mck1117/denso-wideband/nissan-wbo/export/nissan-wbo.pdf

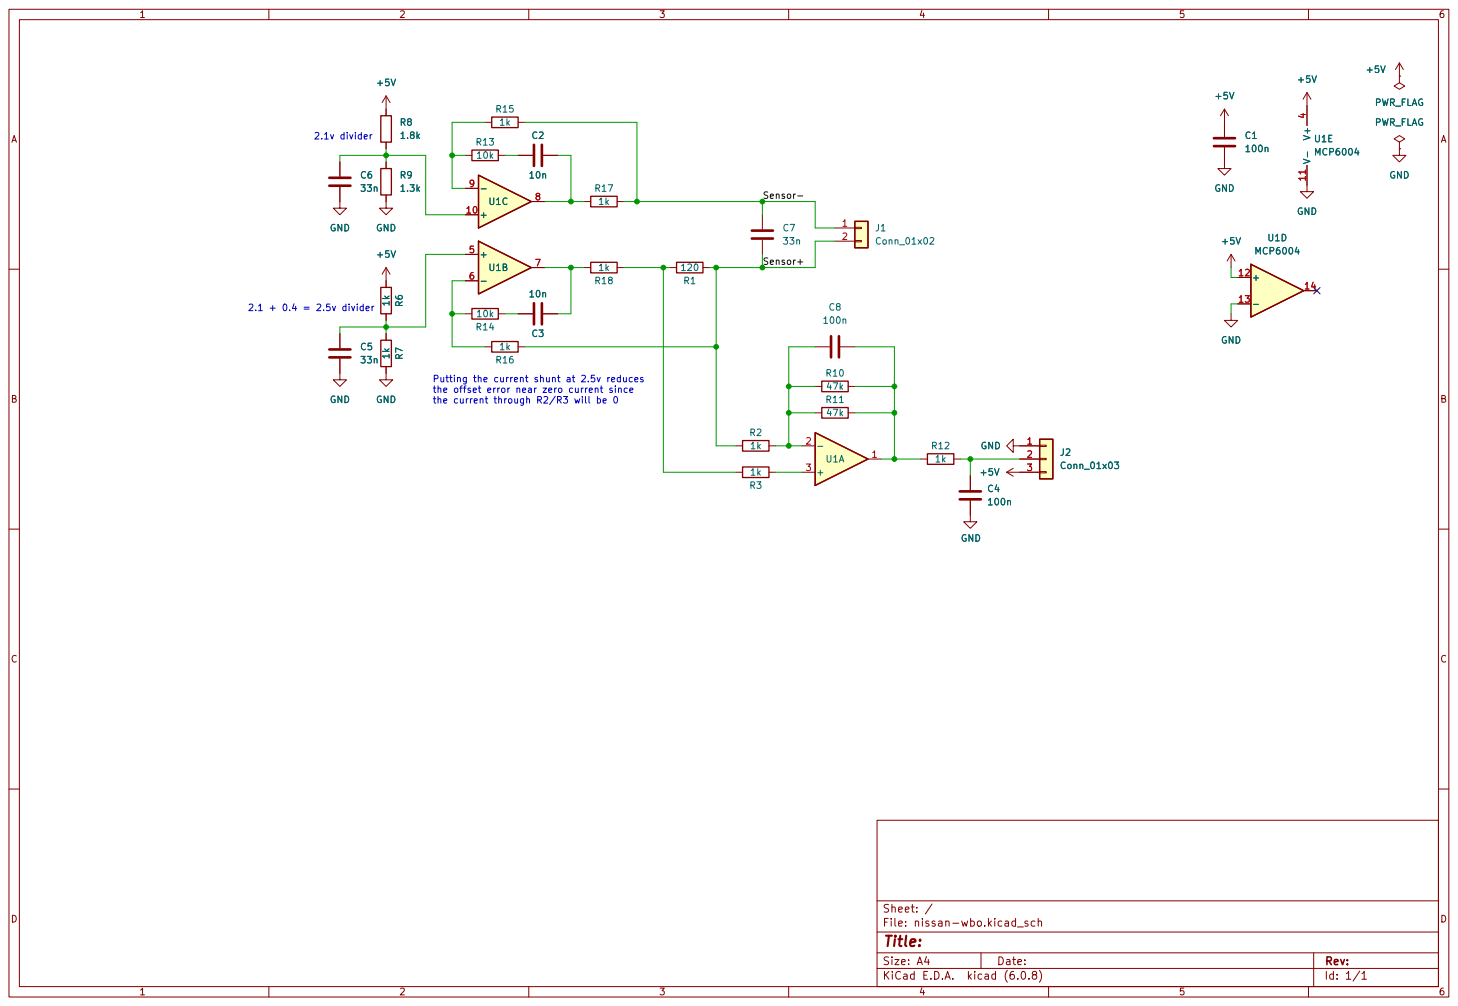
[picture p1: page 1]

the current through R2/R3 will be 0 GND

the offset error near zero current since

File: nissan-wbo.kicad_sch Sheet: /
Id: 1/1 Title:
