mck1117/denso-wideband/sim/NissanWbo.asc

C1: cap; 10n
C2: cap; 10n
C3: cap; 100n
C4: cap; 33n
I1: current; 400µ; AC 1
R1: res; 10k
R2: res; 1k
R3: res; 10k
R4: res; 1k
R5: res; 1k
R6: res; 1k
R7: res; 120
R8: res; 23.5k
R9: res; 1k
R10: res; 1k
U1: AD822
U2: AD822
U3: AD822
V1: voltage; 2.1
V2: voltage; 5
V3: voltage; 2.5
Named nets: 0, vcc, output
.dc I1 -800u 800u
