mck1117/denso-wideband/nissan-wbo/nissan-wbo.kicad_pcb

## KiCad design nissan-wbo/nissan-wbo.kicad_pcb (2023-02-02)

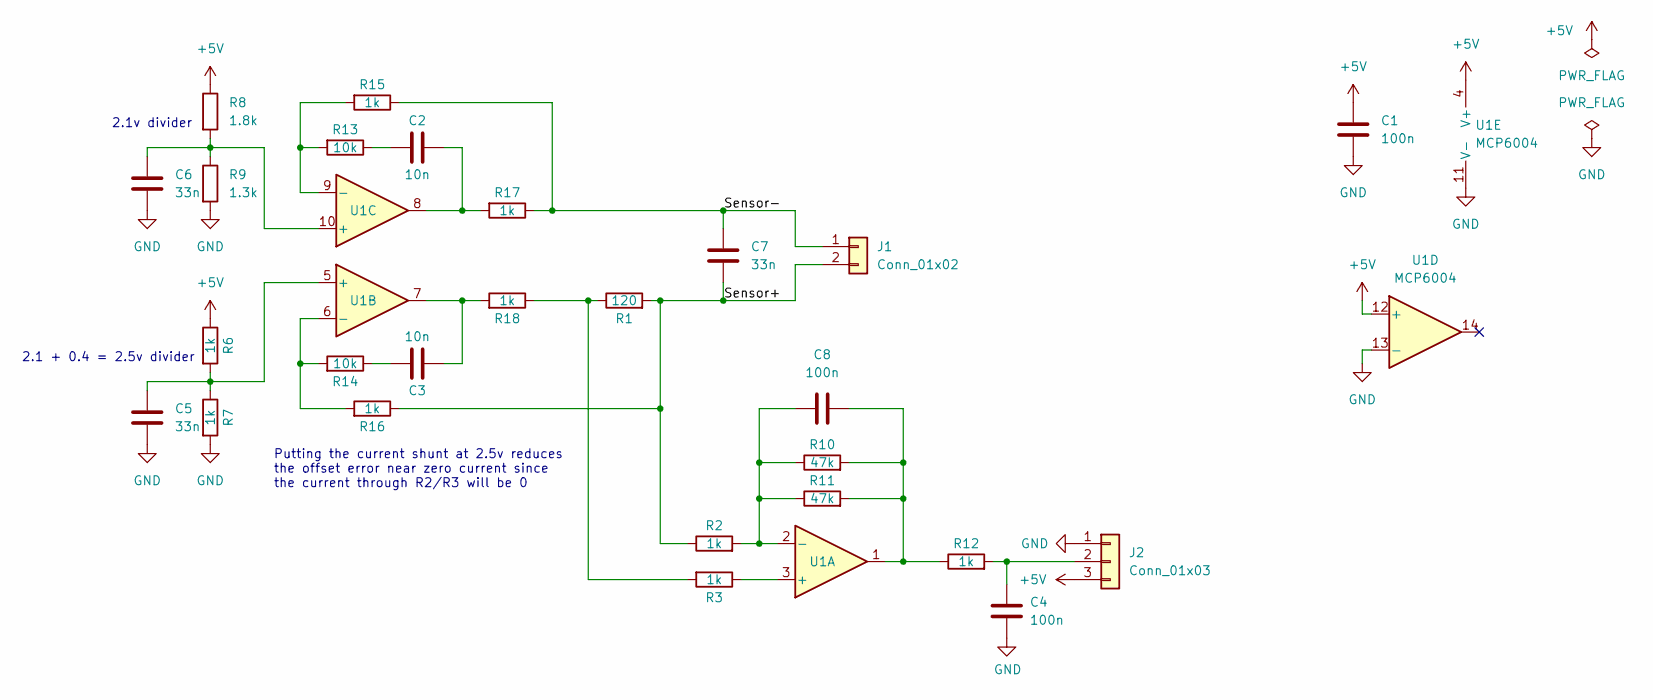
[picture p2: schematic nissan-wbo.kicad_sch]

Parts:
C1, C4, C8: 100n; C_0603_1608Metric; LCSC C57112
C2, C3: 10n; C_0402_1005Metric; LCSC C15195
C5, C6, C7: 33n; C_0402_1005Metric; LCSC C1585
J1: Conn_01x02; SolderWire-0.75sqmm_1x02_P4.8mm_D1.25mm_OD2.3mm
J2: Conn_01x03; SolderWire-0.75sqmm_1x03_P4.8mm_D1.25mm_OD2.3mm
R1: 120; R_0402_1005Metric; LCSC C25079
R2, R3, R6, R7, R12, R15, R16, R17, R18: 1k; R_0402_1005Metric; LCSC C11702
R8: 1.8k; R_0603_1608Metric; LCSC C4177
R9: 1.3k; R_0402_1005Metric; LCSC C227316
R10, R11: 47k; R_0402_1005Metric; LCSC C25792
R13, R14: 10k; R_0402_1005Metric; LCSC C25744
U1: MCP6004; TSSOP-14_4.4x5mm_P0.65mm; LCSC C50282

Connections:
+5V: C1.1, J2.3, R6.1, R8.1, U1.4 (V+), U1.12 (+)
/Sensor+: C7.1, J1.2, R1.2, R2.1, R16.1
/Sensor-: C7.2, J1.1, R15.1, R17.1
GND: C1.2, C4.1, C5.2, C6.2, J2.1, R7.2, R9.2, U1.11 (V-), U1.13 (-)
unnamed: C2.1, R13.1
unnamed: C2.2, R17.2, U1.8
unnamed: C3.1, R14.1
unnamed: C3.2, R18.2, U1.7
unnamed: C4.2, J2.2, R12.2
unnamed: C5.1, R6.2, R7.1, U1.5 (+)
unnamed: C6.1, R8.2, R9.1, U1.10 (+)
unnamed: C8.1, R2.2, R10.1, R11.1, U1.2 (-)
unnamed: C8.2, R10.2, R11.2, R12.1, U1.1
unnamed: R1.1, R3.2, R18.1
unnamed: R3.1, U1.3 (+)
unnamed: R13.2, R15.2, U1.9 (-)
unnamed: R14.2, R16.2, U1.6 (-)

Notes on the sheet:
2.1v divider
2.1 + 0.4 = 2.5v divider
Putting the current shunt at 2.5v reduces the offset error near zero current since the current through R2/R3 will be 0

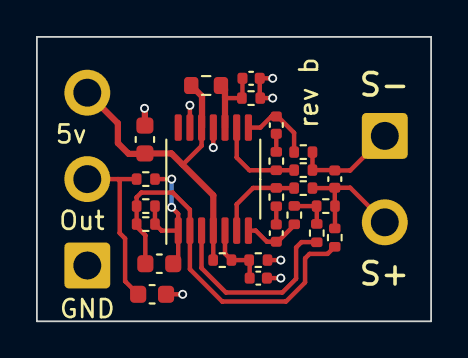
[picture p3: board nissan-wbo.kicad_pcb from above]

Board: 2 copper layers, 21.9 x 15.8 mm, 27 parts (0 on the bottom side), 17 nets.
