mck1117/denso-wideband/(threads)

Thread 6 (2023-02-01):

Cap value?

Qwerty-OFF, 2023-02-01:
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
100n or 10n right?

rusefillc, 2023-02-02:
it's about C4 right?

rusefillc, 2023-02-09:
@mck1117 poke

rusefillc, 2023-02-15:
@mi-hol please see if you can help?

mi-hol, 2023-02-15:
I had no luck to reach @mck1117
Tried via slack since 3Feb, but had no response yet

mck1117, 2023-02-15:
oops, last week was bad time for me.

Yes, the part is wrong. It won't hurt anything to use the wrong value here. That's the output filter cap.

Existing boards will work fine, but I'll fix that anyway.

mi-hol, 2023-02-19:
@mck1117 currently status is "Assignees: No one assigned"
With above statement, would you mind to reflect that task by assigning the issue to yourself?
