mck1117/denso-wideband/(commit log)

2022-12-10 add via (C4, GND) and export gerbers
    [nissan-wbo.csv, nissan-wbo.kicad_pcb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]
2022-12-12 rename columns
    [nissan-wbo-all-pos.csv]
2023-02-02 fix silk
    [nissan-wbo.kicad_pcb]
